pepaslabs/TO-220_breakout/github media/m3_hex_standoffs.jpg

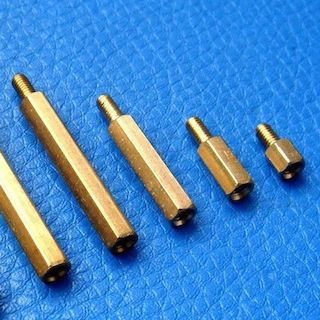
github media/m3_hex_standoffs.jpg
