pepaslabs/TO-220_breakout/github media/530002B02500.jpg

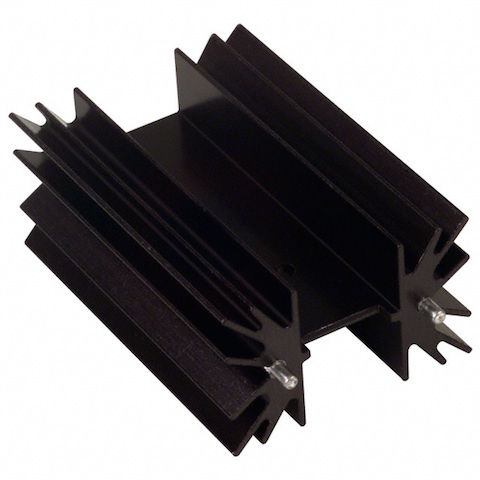
github media/530002B02500.jpg
