pepaslabs/TO-220_breakout/github media/530002B02500_performance.png

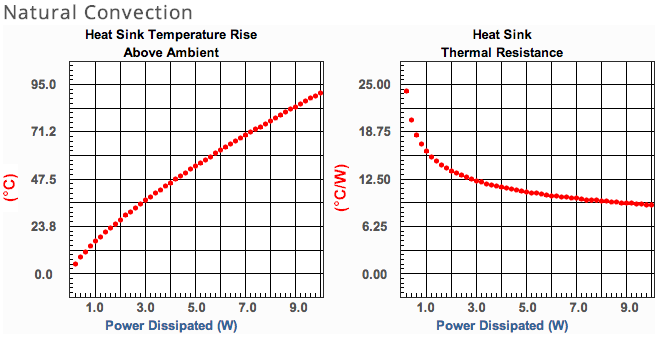
github media/530002B02500_performance.png
