pepaslabs/TO-220_breakout/revisions/v2/bottom.png

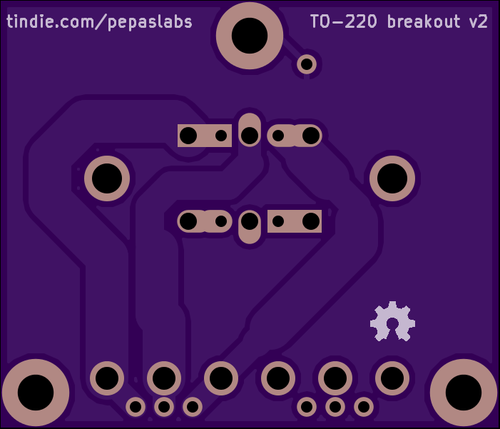
revisions/v2/bottom.png
