pepaslabs/TO-220_breakout/revisions/v2/top.png

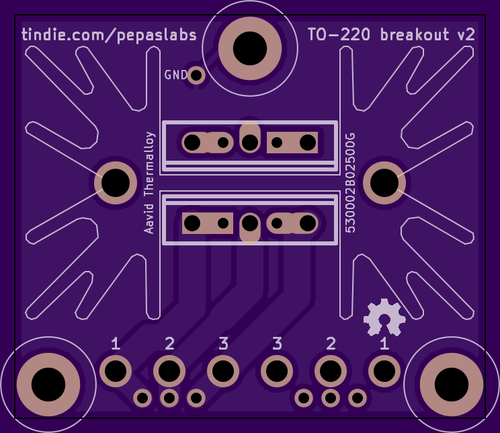
revisions/v2/top.png
