pepaslabs/TO-220_breakout/(commit log)

2014-03-13 adding heatsink image
2014-03-15 pulling in footprint files locally. updating to latest heatsink footprint.
2014-03-15 using .08" trace width to allow larger track clearance (0.02" clearance rather than 0.01").
    [to-220_breakout.kicad_pcb]
2014-03-15 updating output pins.
    [to-220_breakout.kicad_pcb]
2014-03-15 using combo footprint to allow use of to-218 and to-247.
    [to-220_breakout.kicad_pcb]
2014-03-15 trace tweaks
    [to-220_breakout.kicad_pcb]
2014-03-26 using 0.040" drill for smaller holes
    [to-220_breakout.kicad_pcb]
2014-03-26 adding ground planes. fattening traces. using updated M3 mounting hole footprints.
    [to-220_breakout-B_Cu.gbl, to-220_breakout-B_Mask.gbs, to-220_breakout-B_SilkS.gbo, to-220_breakout-Edge_Cuts.gbr, to-220_breakout-F_Cu.gtl, to-220_breakout-F_Mask.gts, to-220_breakout-F_SilkS.gto, to-220_breakout.drl]
2014-03-26 moving ground connection
    [to-220_breakout-B_Cu.gbl, to-220_breakout-B_Mask.gbs, to-220_breakout-B_SilkS.gbo, to-220_breakout-Edge_Cuts.gbr, to-220_breakout-F_Cu.gtl, to-220_breakout-F_Mask.gts, to-220_breakout-F_SilkS.gto, to-220_breakout.drl]
2014-03-26 adjusting copper fills
    [to-220_breakout-B_Cu.gbl, to-220_breakout-B_Mask.gbs, to-220_breakout-B_SilkS.gbo, to-220_breakout-Edge_Cuts.gbr, to-220_breakout-F_Cu.gtl, to-220_breakout-F_Mask.gts, to-220_breakout-F_SilkS.gto, to-220_breakout.drl]
2014-03-26 changing silkscreen URL from tindie.com to github.com
    [to-220_breakout-B_Cu.gbl, to-220_breakout-B_Mask.gbs, to-220_breakout-B_SilkS.gbo, to-220_breakout-Edge_Cuts.gbr, to-220_breakout-F_Cu.gtl, to-220_breakout-F_Mask.gts, to-220_breakout-F_SilkS.gto, to-220_breakout.drl]
